LogicEgg/Lily58/layouts/ideas/alt_layer0_corne.png

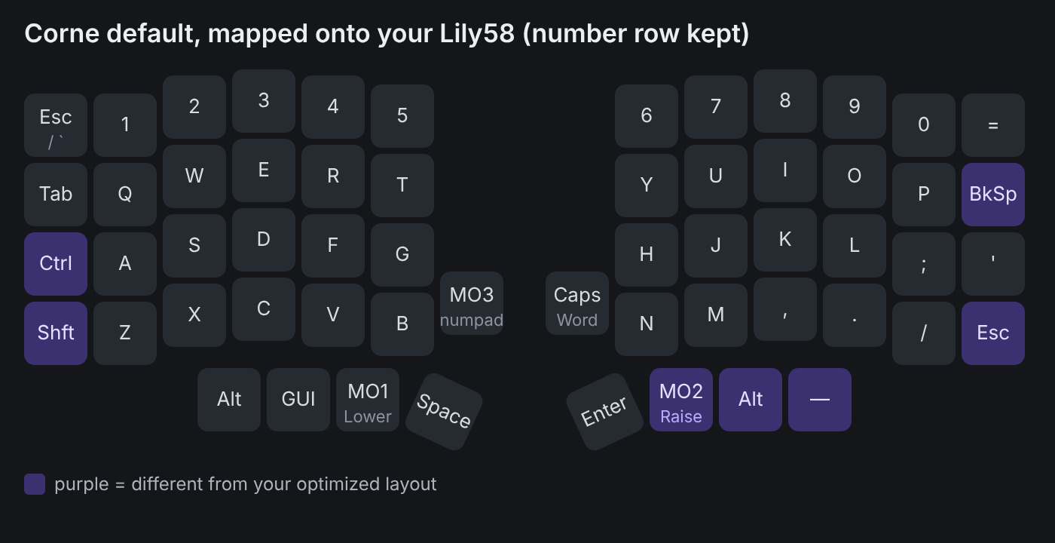
layouts/ideas/alt_layer0_corne.png
