LogicEgg/Lily58/layouts/ideas/alt_layer0_options.png

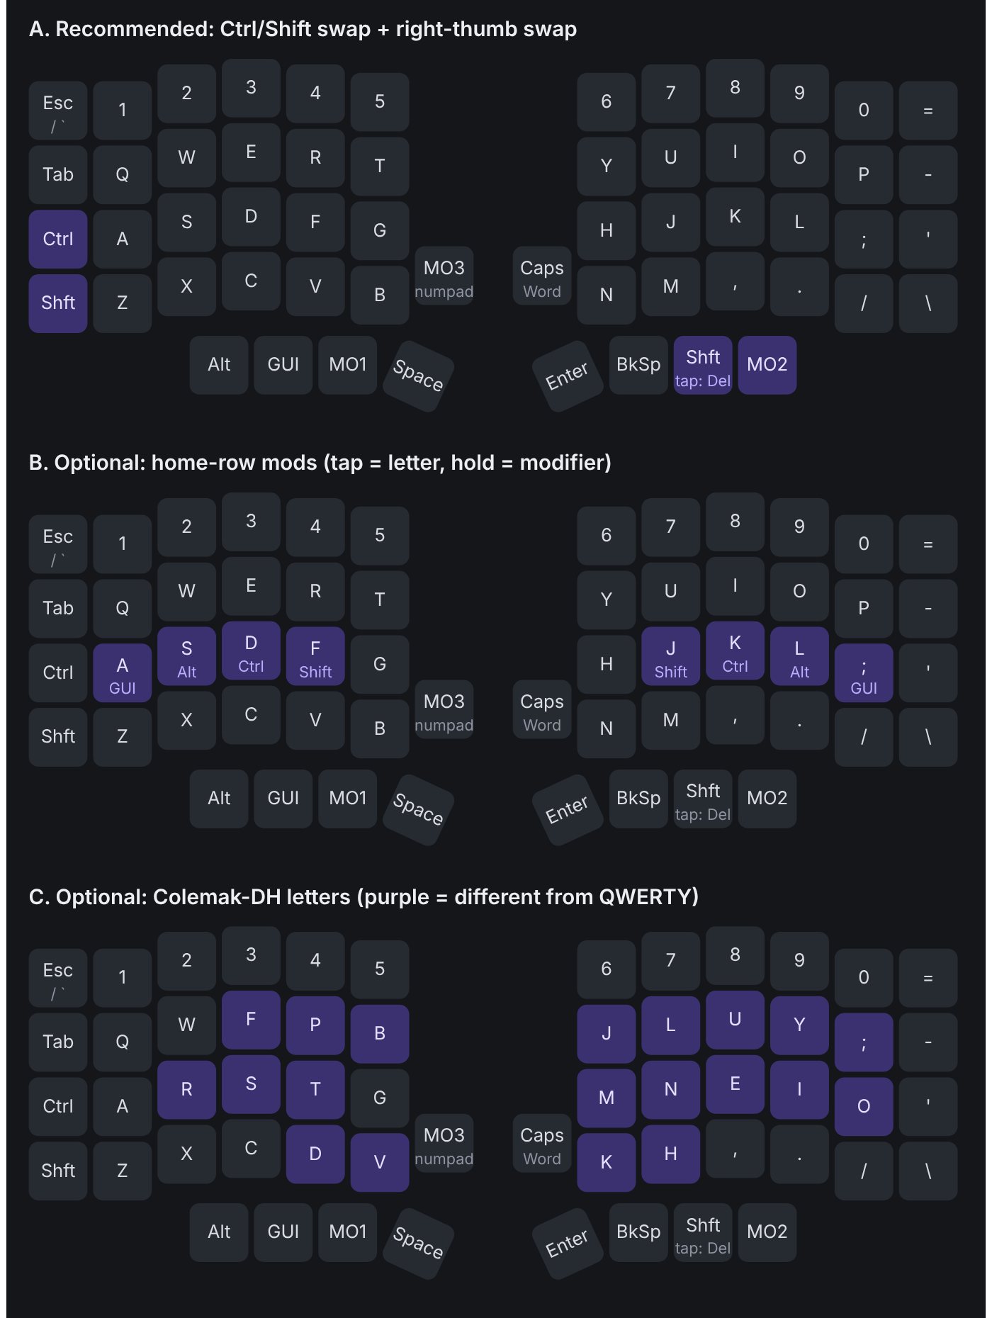
layouts/ideas/alt_layer0_options.png
