LogicEgg/Lily58/layouts/ideas/alt_layer0_split_references.png

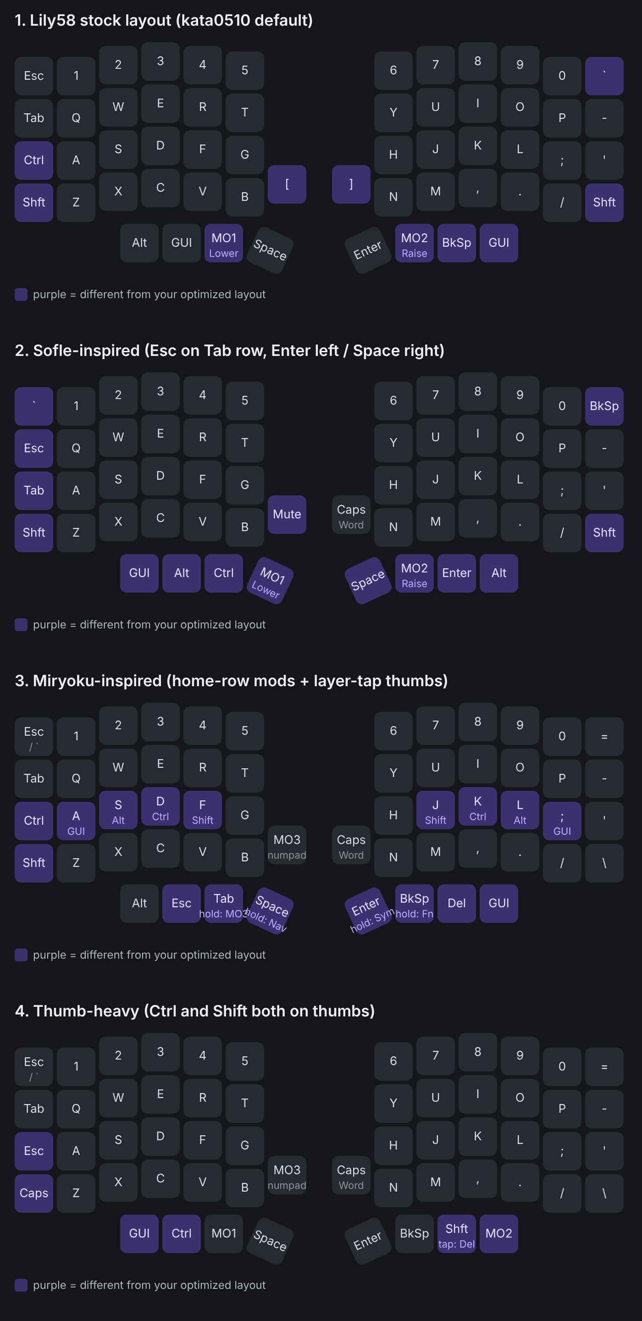
layouts/ideas/alt_layer0_split_references.png
