LogicEgg/Lily58/layouts/ideas/fkeys_on_mo2_all_layers.png

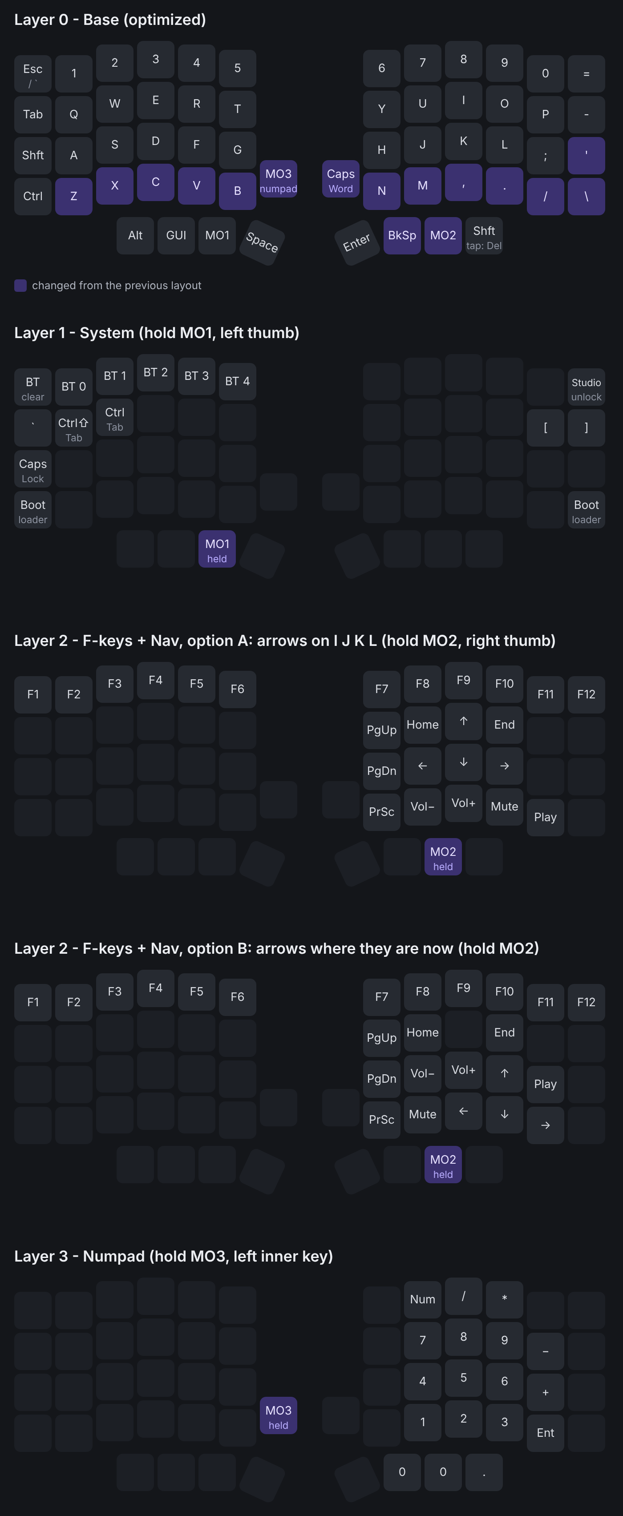
layouts/ideas/fkeys_on_mo2_all_layers.png
