LogicEgg/Lily58/layouts/ideas/layer0_base.png

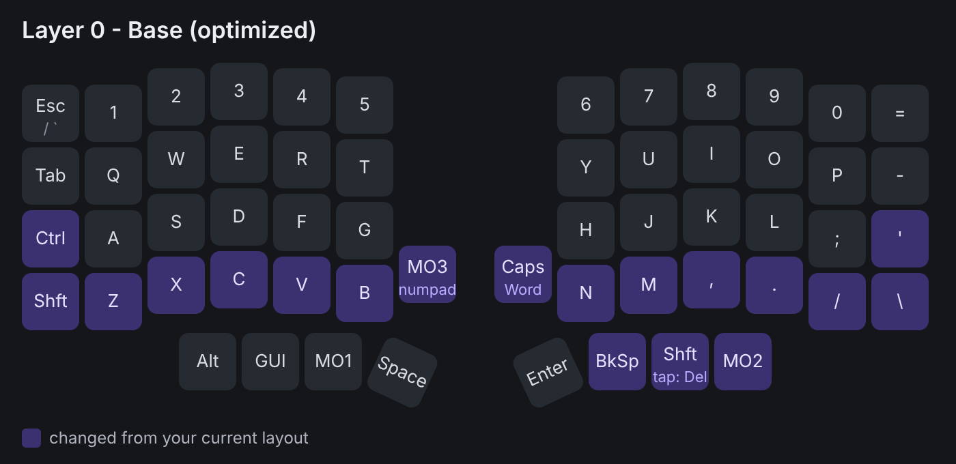
layouts/ideas/layer0_base.png
