LogicEgg/Lily58/layouts/ideas/layer1_nav.png

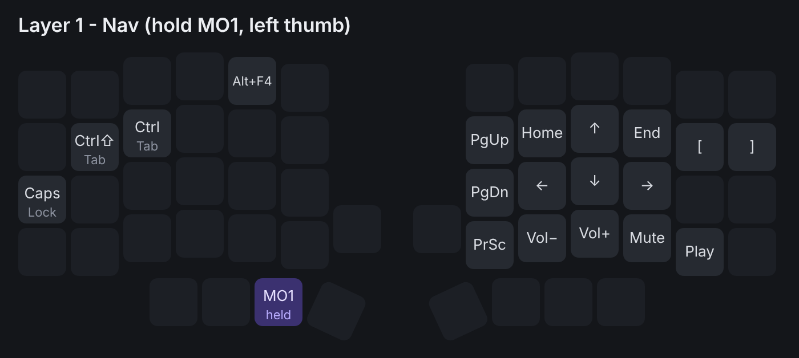
layouts/ideas/layer1_nav.png
