LogicEgg/Lily58/layouts/ideas/layer2_fn_system.png

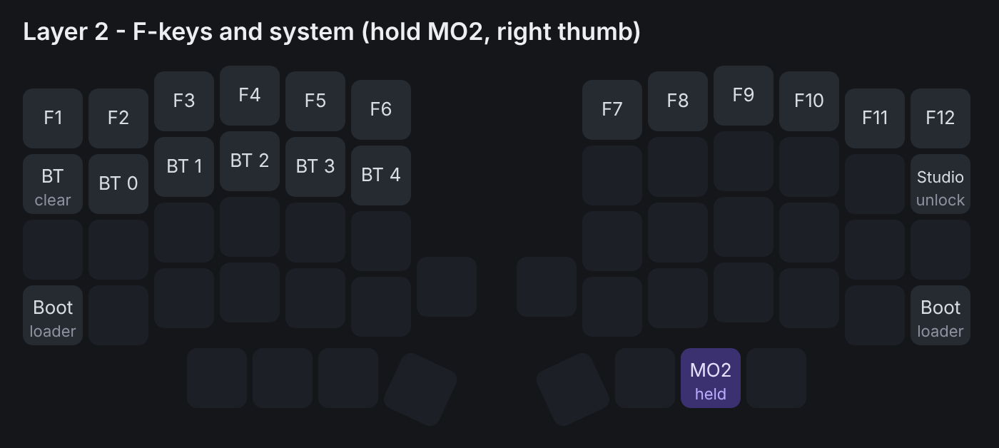
layouts/ideas/layer2_fn_system.png
