LogicEgg/Lily58/layouts/ideas/layer3_numpad.png

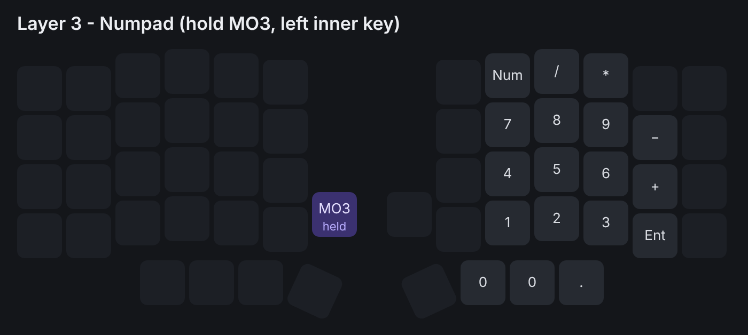
layouts/ideas/layer3_numpad.png
