LogicEgg/Lily58/layouts/ideas/nav_on_mo2_all_layers.png

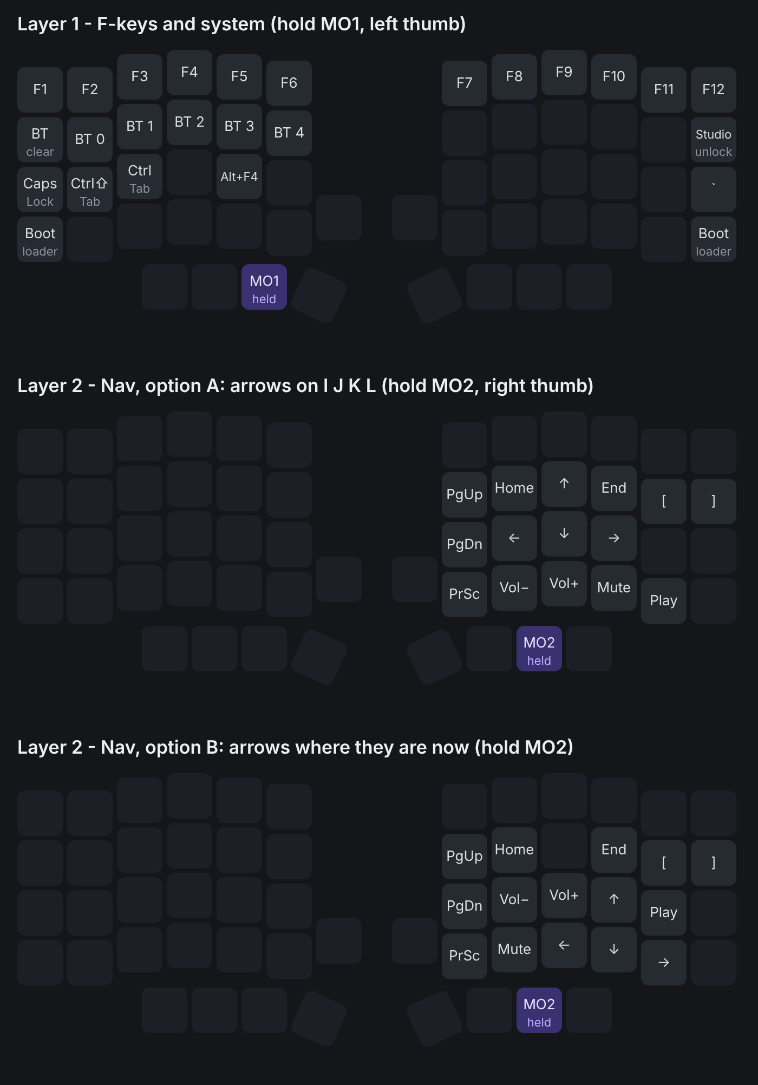
layouts/ideas/nav_on_mo2_all_layers.png
