LogicEgg/Lily58/layouts/ideas/option1_all_layers.png

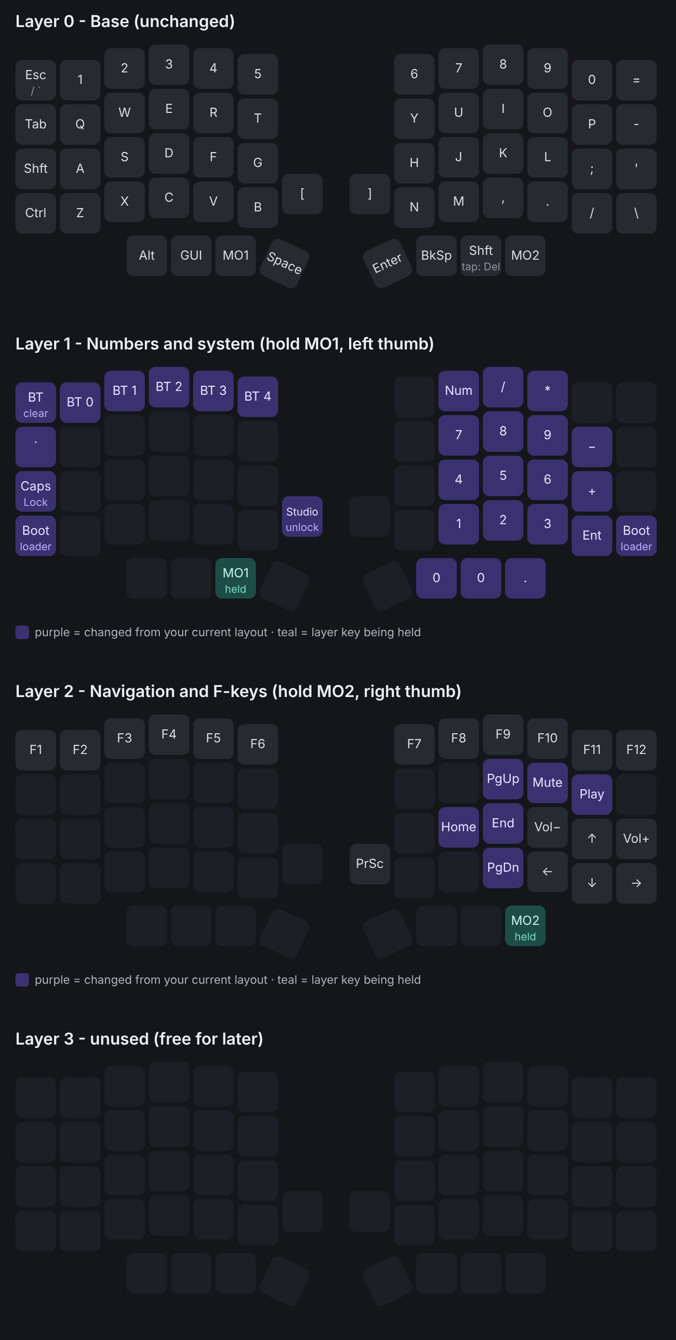
layouts/ideas/option1_all_layers.png
