LogicEgg/Lily58/layouts/ideas/option1_final_all_layers.png

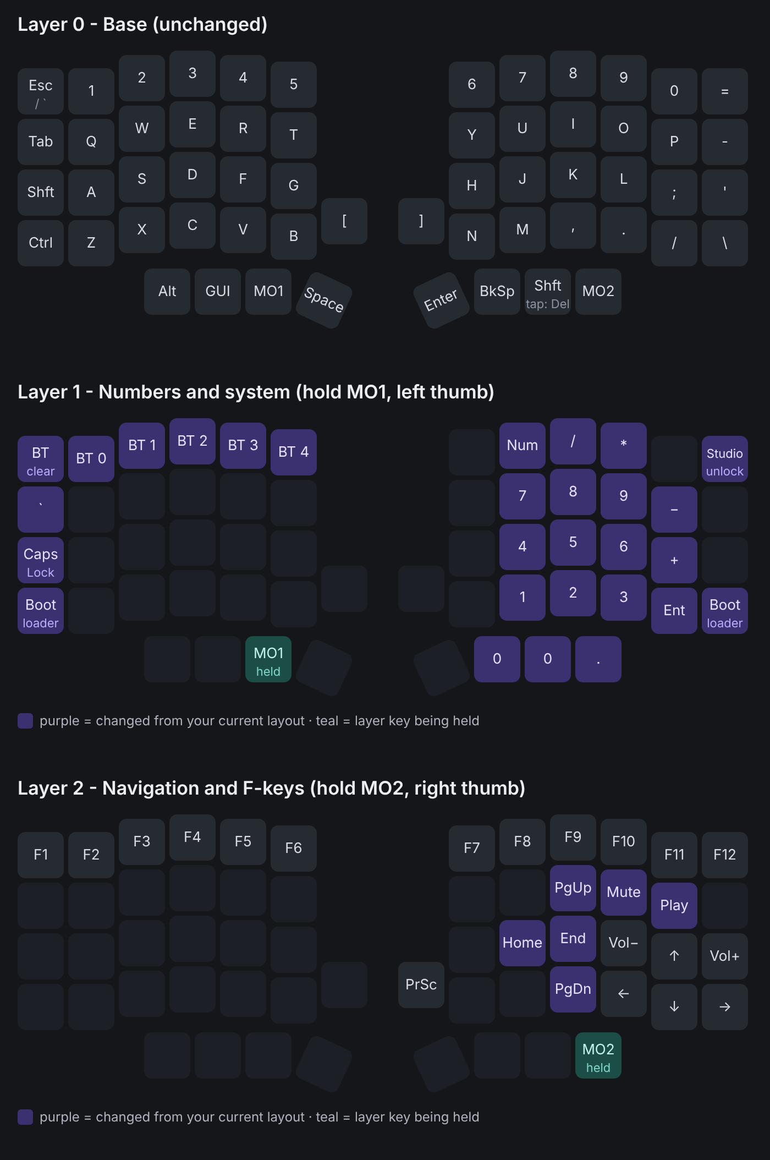
layouts/ideas/option1_final_all_layers.png
