LogicEgg/Lily58/layouts/ideas/two_layer_v1_all_layers.png

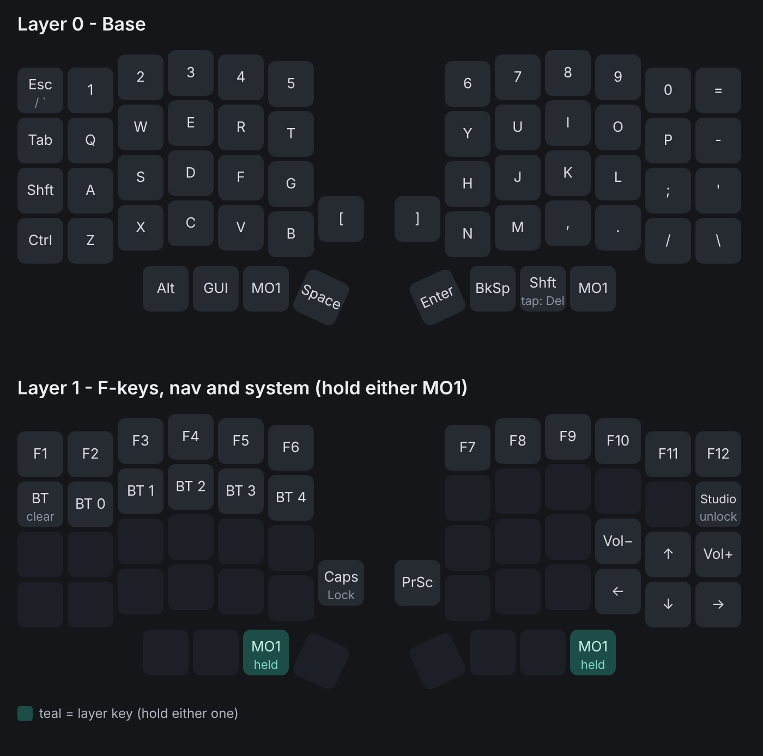
layouts/ideas/two_layer_v1_all_layers.png
