LogicEgg/Lily58/layouts/ideas/two_layer_v2_all_layers.png

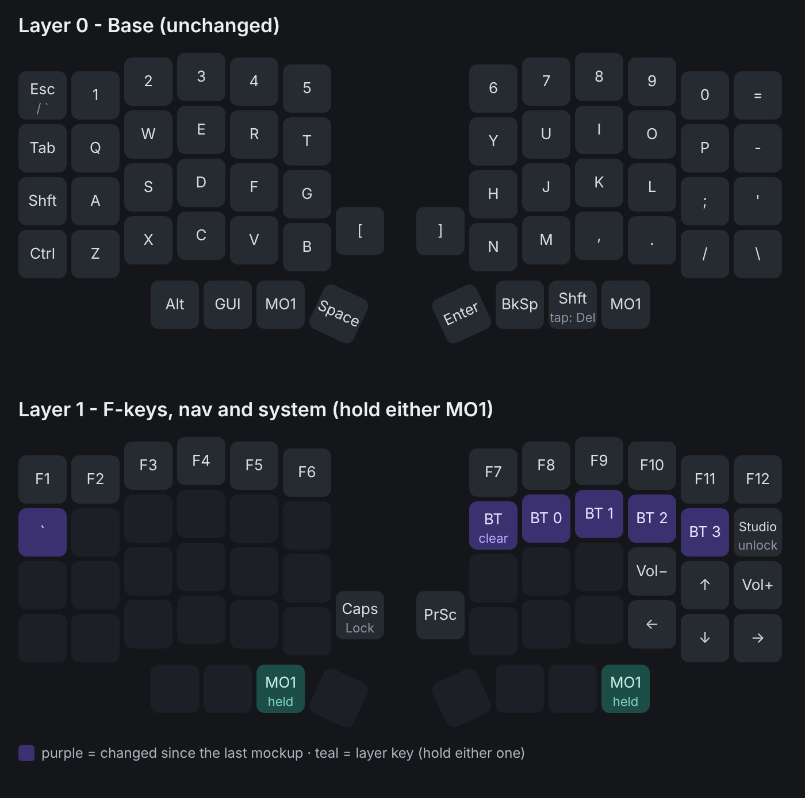
layouts/ideas/two_layer_v2_all_layers.png
