LogicEgg/Lily58/layouts/original/layer0_base.png

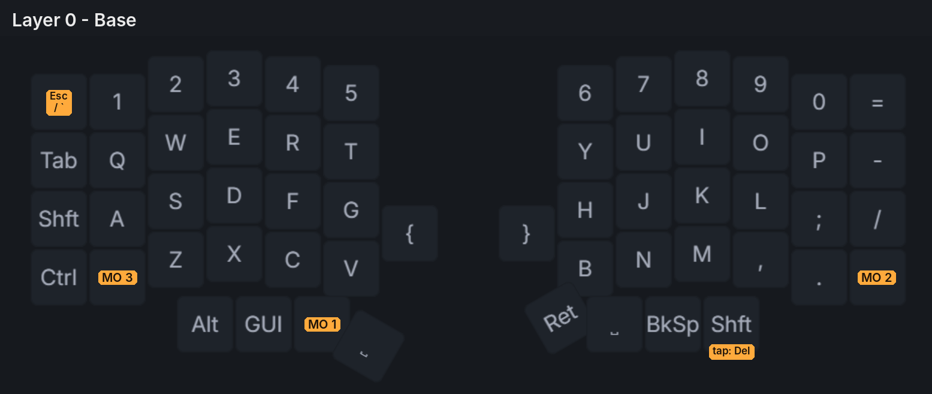
layouts/original/layer0_base.png
