LogicEgg/Lily58/layouts/original/layer1_fn.png

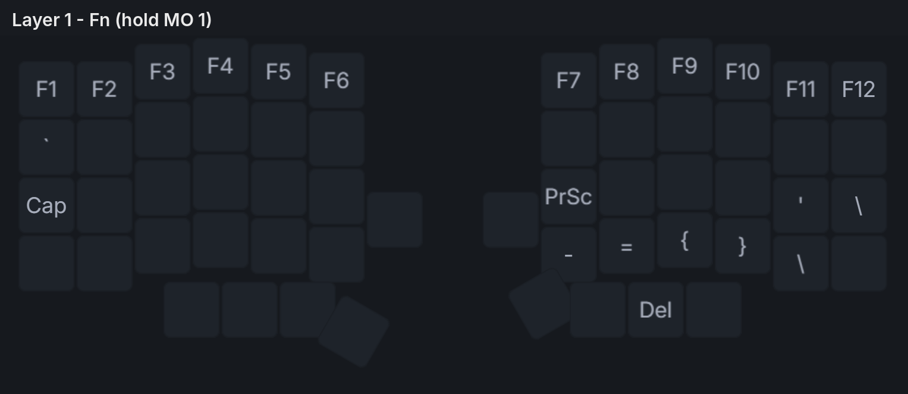
layouts/original/layer1_fn.png
