LogicEgg/Lily58/layouts/original/layer2_nav_bt.png

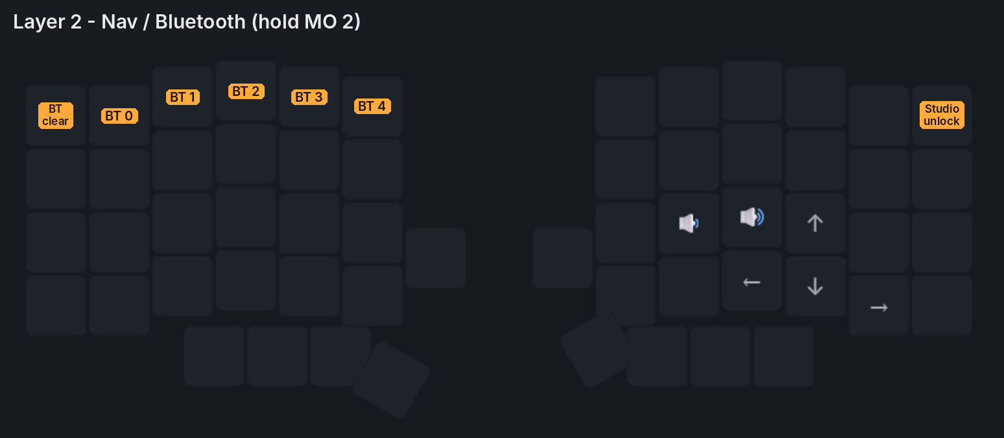
layouts/original/layer2_nav_bt.png
