LogicEgg/Lily58/layouts/original/layer3_numpad.png

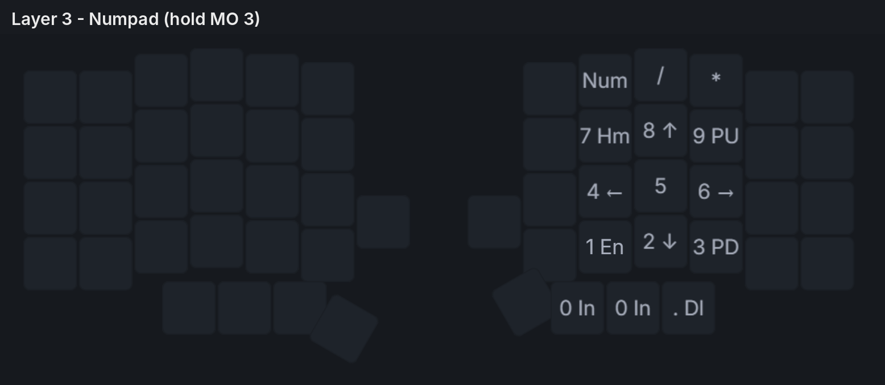
layouts/original/layer3_numpad.png
