LogicEgg/Lily58/case/plate-left_V2_1.5mm-lip.stl

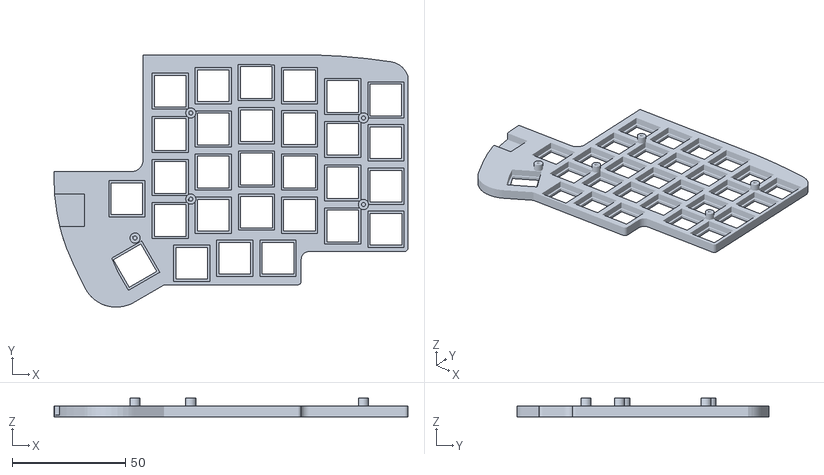
[picture p21: CAD file, 2026-11-06]
case/plate-left_V2_1.5mm-lip.stl
156.2 x 111.4 x 8.30
