LogicEgg/Lily58/case/case-left.stl

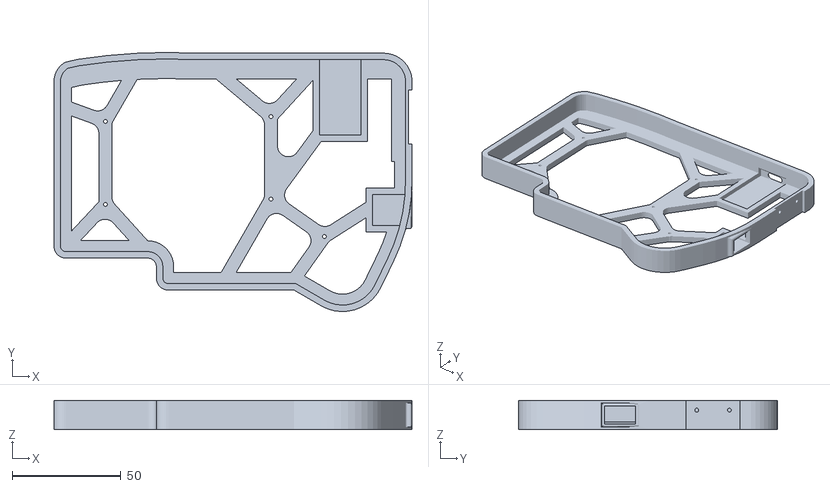
[picture p22: CAD file, 2026-11-04]
case/case-left.stl
164.8 x 119.2 x 13.5
