LogicEgg/Lily58/case/battery-cover.stl

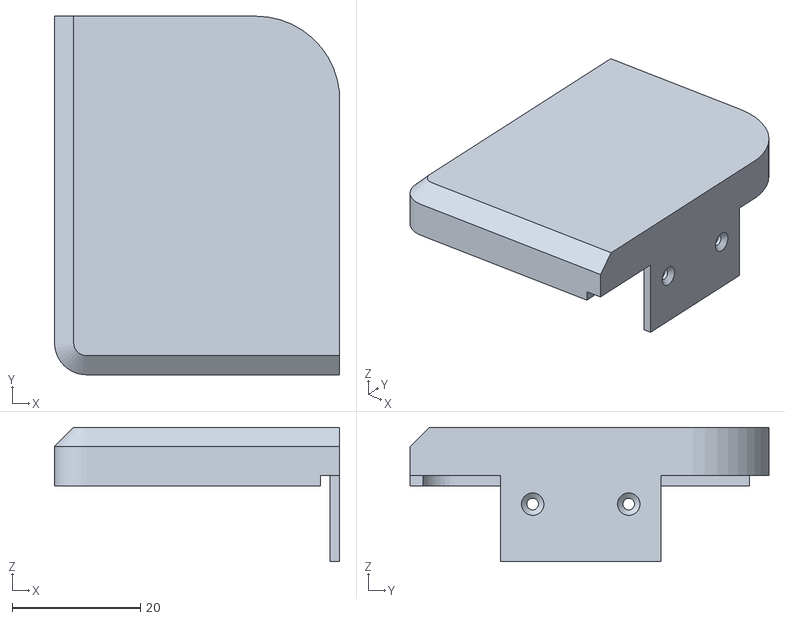
[picture p23: CAD file, 2026-11-04]
case/battery-cover.stl
44.5 x 56.0 x 21.0
