LogicEgg/Lily58/(list of files, cad)

Other CAD files:
case/plate-left.stl
