LogicEgg/Lily58/(commit log)

2026-11-04 added case files, firmware, & layout directory
    [Battery Cover V2.STL, case-left - Re-modelled V2.STL, plate-left - Re-modelled V2.STL]
2026-11-04 Expanded README & renamded case files
    [battery-cover.STL, case-left.STL, plate-left.STL]
2026-11-04 Credit original case design
2026-11-06 add optimized layouts
    [plate-left_V2_1.5mm-lip.stl]
2026-11-06 Update README for current keymap, add wiring photos
2026-11-06 Update firmware link, add screws to parts list
2026-11-06 Fix wiring image paths, lowercase STL extensions
    [battery-cover.stl, case-left.stl, plate-left.stl]
2026-11-06 Lowercase STL extensions, link firmware releases
